WuWingKit/Inverted-pendulum/引脚汇总.md

STM32引脚汇总
PWM输出
| 功能 | 引脚  |
| ---- | --- |
| PWMA | PA0 |
| PWMB | PA1 |
| PWMC | PA2 |
| PWMD | PA3 |

电机方向控制
| 功能 | 引脚 |
| ---- | ---- |
| AIN1 | PC13 |
| AIN2 | PC14 |
| BIN1 | PB13 |
| BIN2 | PB12 |
| CIN1 | PB1  |
| CIN2 | PB0  |
| DIN1 | PC1  |
| DIN2 | PC2  |

编码器输入
| 功能  | 引脚 |
| --- | ---- |
| E1A | PC6  |
| E1B | PC7  |
| E2A | PA15 |
| E2B | PB3  |
| E3A | PA7  |
| E3B | PA6  |
| E4A | PA8  |
| E4B | PA4  |

其他
| 功能 | 引脚 |
| ----- | ---- |
| ADC采样 | PA5  |
| STBY  | 3.3V |
| GND | GND  |

### WDD35D4 角位移传感器

| 功能 | 引脚 | 说明 |
|---|---|---|
| Sensor Signal | PC4 | ADC1_CH14，模拟电压输入（0~3.3V 对应 0~340°） |
| Sensor VCC | 3.3V | 传感器供电 |
| Sensor GND | GND | 传感器地 |
