WuWingKit/Inverted-pendulum/SYSTEM/usart/usart.h

#ifndef __USART_H
#define __USART_H
#include "stdio.h"	
#include "sys.h" 
//////////////////////////////////////////////////////////////////////////////////	 









//All rights reserved
//********************************************************************************












#define USART_REC_LEN  			200
#define EN_USART1_RX 			1
	  	
extern u8  USART_RX_BUF[USART_REC_LEN];
extern volatile u16 USART_RX_STA;

void uart_init(u32 bound);
#endif
