WuWingKit/Inverted-pendulum/HAREWER/LCD/lcd_init.c

#include "lcd_init.h"
#include "delay.h"

void LCD_GPIO_Init(void)
{
	GPIO_InitTypeDef GPIO_InitStructure;
	RCC_APB2PeriphClockCmd(RCC_APB2Periph_GPIOB | RCC_APB2Periph_AFIO, ENABLE);
	// PB4 is JTAG NJTRST by default. Disable JTAG but keep SWD for download/debug.
	GPIO_PinRemapConfig(GPIO_Remap_SWJ_JTAGDisable, ENABLE);
	GPIO_InitStructure.GPIO_Pin = GPIO_Pin_4|GPIO_Pin_5|GPIO_Pin_6|GPIO_Pin_7|GPIO_Pin_8|GPIO_Pin_9;
	GPIO_InitStructure.GPIO_Mode = GPIO_Mode_Out_PP;
	GPIO_InitStructure.GPIO_Speed = GPIO_Speed_50MHz;
	GPIO_Init(GPIOB, &GPIO_InitStructure);
	GPIO_SetBits(GPIOB, GPIO_Pin_4|GPIO_Pin_5|GPIO_Pin_6|GPIO_Pin_7|GPIO_Pin_8|GPIO_Pin_9);
}

void LCD_Writ_Bus(u8 dat)
{
	u8 i;
	LCD_CS_Clr();
	for(i=0;i<8;i++)
	{
		LCD_SCLK_Clr();
		if(dat&0x80)
		{
			LCD_MOSI_Set();
		}
		else
		{
			LCD_MOSI_Clr();
		}
		LCD_SCLK_Set();
		dat<<=1;
	}
	LCD_CS_Set();
}

void LCD_WR_DATA8(u8 dat)
{
	LCD_Writ_Bus(dat);
}

void LCD_WR_DATA(u16 dat)
{
	LCD_Writ_Bus(dat>>8);
	LCD_Writ_Bus(dat);
}

void LCD_WR_REG(u8 dat)
{
	LCD_DC_Clr();
	LCD_Writ_Bus(dat);
	LCD_DC_Set();
}

void LCD_Address_Set(u16 x1,u16 y1,u16 x2,u16 y2)
{
	if(USE_HORIZONTAL==0)
	{
		LCD_WR_REG(0x2a);
		LCD_WR_DATA(x1+2);
		LCD_WR_DATA(x2+2);
		LCD_WR_REG(0x2b);
		LCD_WR_DATA(y1+1);
		LCD_WR_DATA(y2+1);
		LCD_WR_REG(0x2c);
	}
	else if(USE_HORIZONTAL==1)
	{
		LCD_WR_REG(0x2a);
		LCD_WR_DATA(x1+2);
		LCD_WR_DATA(x2+2);
		LCD_WR_REG(0x2b);
		LCD_WR_DATA(y1+3);
		LCD_WR_DATA(y2+3);
		LCD_WR_REG(0x2c);
	}
	else if(USE_HORIZONTAL==2)
	{
		LCD_WR_REG(0x2a);
		LCD_WR_DATA(x1+1);
		LCD_WR_DATA(x2+1);
		LCD_WR_REG(0x2b);
		LCD_WR_DATA(y1+2);
		LCD_WR_DATA(y2+2);
		LCD_WR_REG(0x2c);
	}
	else
	{
		LCD_WR_REG(0x2a);
		LCD_WR_DATA(x1+3);
		LCD_WR_DATA(x2+3);
		LCD_WR_REG(0x2b);
		LCD_WR_DATA(y1+2);
		LCD_WR_DATA(y2+2);
		LCD_WR_REG(0x2c);
	}
}

void LCD_Init(void)
{
	LCD_GPIO_Init();

	LCD_RES_Clr();
	delay_ms(100);
	LCD_RES_Set();
	delay_ms(100);

	LCD_BLK_Set();
	delay_ms(100);

	LCD_WR_REG(0x11);
	delay_ms(120);

	LCD_WR_REG(0xB1);
	LCD_WR_DATA8(0x02);
	LCD_WR_DATA8(0x35);
	LCD_WR_DATA8(0x36);
	LCD_WR_REG(0xB2);
	LCD_WR_DATA8(0x02);
	LCD_WR_DATA8(0x35);
	LCD_WR_DATA8(0x36);
	LCD_WR_REG(0xB3);
	LCD_WR_DATA8(0x02);
	LCD_WR_DATA8(0x35);
	LCD_WR_DATA8(0x36);
	LCD_WR_DATA8(0x02);
	LCD_WR_DATA8(0x35);
	LCD_WR_DATA8(0x36);

	LCD_WR_REG(0xB4);
	LCD_WR_DATA8(0x03);

	LCD_WR_REG(0xC0);
	LCD_WR_DATA8(0xA2);
	LCD_WR_DATA8(0x02);
	LCD_WR_DATA8(0x84);
	LCD_WR_REG(0xC1);
	LCD_WR_DATA8(0xC5);
	LCD_WR_REG(0xC2);
	LCD_WR_DATA8(0x0D);
	LCD_WR_DATA8(0x00);
	LCD_WR_REG(0xC3);
	LCD_WR_DATA8(0x8D);
	LCD_WR_DATA8(0x2A);
	LCD_WR_REG(0xC4);
	LCD_WR_DATA8(0x8D);
	LCD_WR_DATA8(0xEE);

	LCD_WR_REG(0xC5);
	LCD_WR_DATA8(0x0a);
	LCD_WR_REG(0x36);
	if(USE_HORIZONTAL==0)LCD_WR_DATA8(0x08);
	else if(USE_HORIZONTAL==1)LCD_WR_DATA8(0xC8);
	else if(USE_HORIZONTAL==2)LCD_WR_DATA8(0x78);
	else LCD_WR_DATA8(0xA8);

	LCD_WR_REG(0XE0);
	LCD_WR_DATA8(0x12);
	LCD_WR_DATA8(0x1C);
	LCD_WR_DATA8(0x10);
	LCD_WR_DATA8(0x18);
	LCD_WR_DATA8(0x33);
	LCD_WR_DATA8(0x2C);
	LCD_WR_DATA8(0x25);
	LCD_WR_DATA8(0x28);
	LCD_WR_DATA8(0x28);
	LCD_WR_DATA8(0x27);
	LCD_WR_DATA8(0x2F);
	LCD_WR_DATA8(0x3C);
	LCD_WR_DATA8(0x00);
	LCD_WR_DATA8(0x03);
	LCD_WR_DATA8(0x03);
	LCD_WR_DATA8(0x10);
	LCD_WR_REG(0XE1);
	LCD_WR_DATA8(0x12);
	LCD_WR_DATA8(0x1C);
	LCD_WR_DATA8(0x10);
	LCD_WR_DATA8(0x18);
	LCD_WR_DATA8(0x2D);
	LCD_WR_DATA8(0x28);
	LCD_WR_DATA8(0x23);
	LCD_WR_DATA8(0x28);
	LCD_WR_DATA8(0x28);
	LCD_WR_DATA8(0x26);
	LCD_WR_DATA8(0x2F);
	LCD_WR_DATA8(0x3B);
	LCD_WR_DATA8(0x00);
	LCD_WR_DATA8(0x03);
	LCD_WR_DATA8(0x03);
	LCD_WR_DATA8(0x10);

	LCD_WR_REG(0x3A);
	LCD_WR_DATA8(0x05);

	LCD_WR_REG(0x29);
}
