WuWingKit/Inverted-pendulum/(commit log)

2026-06-05 @ Initial commit: STM32 D24A demo project (Hall encoder based inverted pendulum)
    Project structure:
    - CORE: CMSIS core support files
    - HAREWER: Hardware drivers (LCD, etc.)
    - OBJ: Object/build files
    - STM32F10x_FWLIB: STM32F10x standard peripheral library
    - SYSTEM: System-level configuration (delay, sys, usart)
    - USER: Application code (main.c, Tb6612demo.uvprojx)
    - keilkill.bat: Keil build cleanup script
    @
    [adc.c, encoder.c, encoder.h, lcd.c, lcd.h]
2026-06-05 docs: 添加团队协作指南和开发文档 > > - CONTRIBUTING.md: Git工作流、分支规范、冲突处理、PR流程 > - DEVLOG.md: 项目架构、硬件资源分配、当前状态、已知问题、开发日志 > - 明确要求每次代码更新后需同步更新DEVLOG.md > > Co-Authored-By: Claude Opus 4.8 <noreply@anthropic.com>
2026-06-05 LCD适配 + D编码器引脚调整(PD10/PB11) + RCT6启动文件更换
2026-06-05 fix: 修复TIM8中断处理函数名称 + 修正注释错误
    - TIM8_IRQHandler → TIM8_UP_IRQHandler 匹配HD启动文件向量表
    - 修正 Encoder_Init_Tim8 注释（原错误标注为TIM1）
    - 修正 Encoder_Init_Tim3 注释（原错误标注为TIM2）
    [encoder.c]
2026-06-05 docs: 更新开发日志 - 记录TIM8修复及C/D编码器硬件调试指南
2026-06-05 docs: 重写团队协作指南 - 加入PR工作流和分支保护规则
2026-06-05 Create STM32引脚汇总
2026-06-05 docs: 添加引脚汇总文档并更新开发日志
    - 新建 引脚汇总.md 记录实际硬件引脚映射
    - 标注D编码器/E3相位/B电机方向引脚与代码差异
    - DEVLOG 追加本次文档更新条目
2026-06-05 D编码器改用TIM6 1ms定时器中断轮询替代50ms主循环轮询
2026-06-05 fix: D编码器TIM6轮询频率从1kHz提升至50kHz改善读数精度
2026-06-05 docs: 更新开发日志 - D编码器TIM6 50kHz轮询方案
2026-06-05 调整TargetVelocity从500降至300实现低速直行
2026-06-05 调PID参数Kp=0.5 Ki=0.15 + B编码器读数取反 + TargetVelocity=300
2026-06-05 docs: 更新开发日志 - B轮方向修正+PID调参+目标速度降低
2026-06-09 docs: 添加中英文README + 修复DEVLOG合并冲突 + 标准化开发日志格式
    - 新增 README.md (英文主文档)
    - 新增 README_CN.md (中文文档, 从英文版链接)
    - 修复 DEVLOG.md 中未解决的 Git 合并冲突
    - 合并 hzx 与 tulip627722 的开发日志条目
    - 统一所有日志条目格式
2026-06-09 docs: DEVLOG 补充本次文档更新记录
2026-06-09 docs: README 添加依赖勋章 + 补充团队成员 Lisa-TTT, zzz-rh
2026-06-09 docs: Lisa-TTT 职责补充为角速度传感器开发
2026-06-14 feat: integrate WDD35D4 angular displacement sensor, ADC test mode
    - Add PC4 (ADC1_CH14) analog input initialization for WDD35D4 sensor
    - Add Kalman filter + complementary filter for angle smoothing
    - Switch main.c to sensor-only test mode (motors fully disabled)
    - LCD displays raw ADC value, converted angle (degrees), battery voltage
    - Serial outputs angle data at 20Hz
    - Update pin reference table with WDD35D4 pin mapping
    - Update DEVLOG with 2026-06-14 integration entry
    WDD35D4 wiring: VCC→3.3V, GND→GND, Signal→PC4
2026-06-14 chore: add filter.c source and include path to Keil project
2026-06-14 fix: avoid float display bug in LCD_ShowFloatNum1, use fixed-point int
    LCD_ShowFloatNum1 does not handle negative values properly. Replaced all float display with integer arithmetic (value*100 then split int/frac parts) to fix white screen issue.
    [main.c]
2026-06-14 feat: merge motor control with WDD35D4 angle sensor display
    Restore motor control (PWM/encoders/PI) alongside WDD35D4 ADC reading.
    LCD_Show_Debug now shows all 4 motors + angle data on rows 7-8.
    Angle uses fixed-point int to avoid LCD_ShowFloatNum1 negative bug.
    [main.c]
2026-06-14 fix: disable motors, keep WDD35D4 angle sensor display only
    [main.c]
2026-06-14 fix: restore all motor code, add WDD35D4 ADC reading on row 7
    Minimal change on top of original main.c: only add angle_adc reading and display. All motor/encoder/PWM/PI code unchanged.
    [main.c]
2026-06-14 test: set TargetVelocity=0 to stop motors, verify no white screen
2026-06-14 feat: add WDD35D4 angle sensor ADC display (minimal, single read)
2026-06-14 feat: WDD35D4 angle calibration - serial 'z' to zero, display angle with decimals
2026-06-15 修改USER/main.c里的PID控制逻辑
2026-06-16 feat: add key zero calibration
2026-06-16 fix: align USART_RX_STA volatile declaration
    [usart.c, usart.h]
2026-06-16 tune: invert balance output direction
    [balance.h]
2026-06-16 tune: fix forward balance direction
    [balance.h]
2026-06-16 tune: raise balance correction speed
    [balance.c, balance.h]
2026-06-16 tune: improve rescue damping and zero calibration
2026-06-17 fix: stabilize startup before balance tuning
    [balance.c, balance.h, encoder.c, main.c]
2026-06-17 revert: restore pre-loop-timing balance state
    [balance.c, encoder.c, main.c]
2026-06-17 fix: keep SWD enabled during TIM2 remap
    [encoder.c]
2026-06-17 fix: release PB4 before LCD init
    [lcd_init.c]
2026-06-17 refactor: move balance loop into timer interrupt
2026-06-17 fix: add motor pwm deadzone compensation
    [pwm.c]
2026-06-17 tune: reduce upright jitter and boost rescue
    [balance.c, balance.h, pwm.c]
2026-06-17 tune: compensate small angle center drift
    [balance.c, balance.h, main.c]
2026-06-17 tune: smooth damping and pwm deadzone
2026-06-17 tune: prevent braking before center
    [balance.c]
2026-06-17 tune: limit small angle speed drift
    [balance.c, balance.h]
2026-06-17 fix: avoid rescue interpolation divide by zero
    [balance.c, balance.h]
2026-06-17 tune: prioritize fall prevention over settling
    [balance.c, balance.h]
2026-06-17 tune: pull back during drift
    [balance.c, balance.h]
2026-06-17 tune: add drift kick recovery
    [balance.c, balance.h]
2026-06-17 tune: reduce motor pwm deadzone
2026-06-17 fix: remove small angle drift feedback traps
    [balance.c, balance.h, main.c]
2026-09-14 Archive project materials and bilingual documentation
